yui-project/Ra-01_Handy_Neo/README.md

# Ra-01_Handy_Neo
## やりたいこと（適当）
- PC接続を不要にする
  - 0~9，Enter, BS, 文字切り替えの13ボタンによって、文字入力
  - キャラクターLCRによって、画面表示
