yui-project/Ra-01_Handy_Neo/hardware/case/components/mainpcb.step

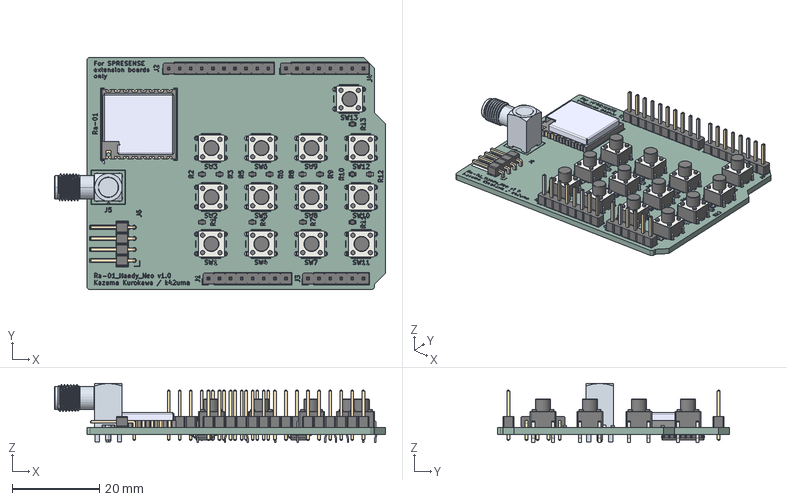
[picture p1: CAD file, 2026-05-15]
hardware/case/components/mainpcb.step
76.0 x 53.3 x 13.6 mm
PinHeader_1x08_P2.54mm_Vertical x 2
PinHeader_1x06_P2.54mm_Vertical
PinHeader_1x10_P2.54mm_Vertical
SW_PUSH_6mm_H6.5mm_Original x 13
R_0603_1608Metric x 13
Ra-01
PinHeader_1x04_P2.54mm_Horizontal
JEITA_SOIC-16_3.9x9.9mm_P1.27mm x 2
Ra-01_Handy_Neo_silkscreen
Ra-01_Handy_Neo_PCB
