yui-project/Ra-01_Handy_Neo/hardware/case/LoRa_Handy_Neo_Case_2.3mf

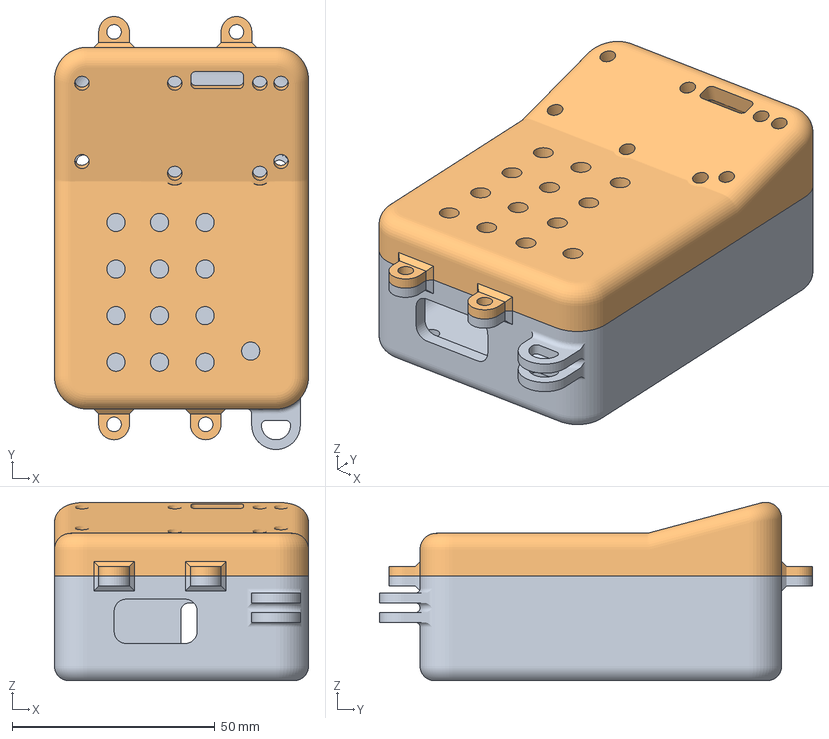
[picture p2: CAD file, 2026-07-19]
hardware/case/LoRa_Handy_Neo_Case_2.3mf
62.7 x 106.9 x 44.0 mm
ボディ1
ボディ8
