yui-project/Ra-01_Handy_Neo/hardware/case/LoRa_Handy_Button_For_Print.3mf

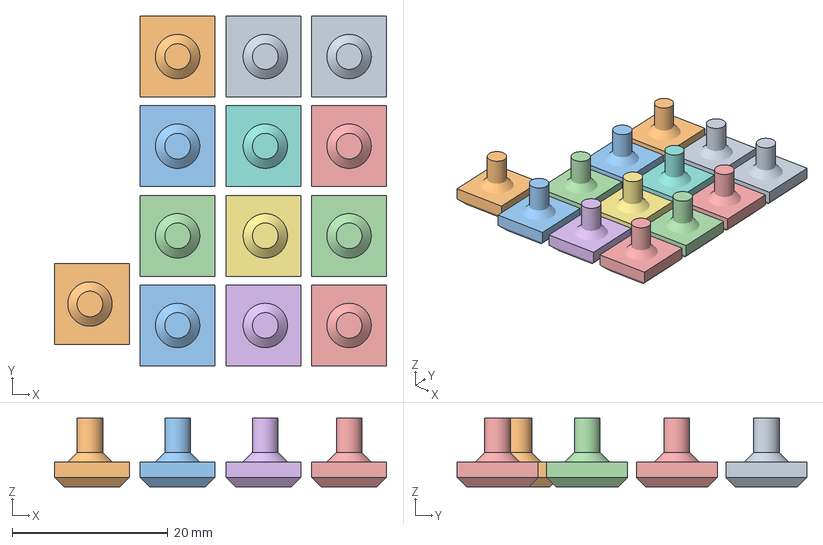
[picture p3: CAD file, 2026-07-19]
hardware/case/LoRa_Handy_Button_For_Print.3mf
42.6 x 44.9 x 8.80 mm
ボディ1
ボディ10
ボディ11
ボディ12
ボディ13
ボディ14
ボディ15
ボディ16
ボディ17
ボディ18
ボディ2
ボディ3
ボディ9
