yui-project/Ra-01_Handy_Neo/hardware/Ra-01_Handy_Neo/Ra-01_Handy_Neo.kicad_pcb

## KiCad design hardware/Ra-01_Handy_Neo/Ra-01_Handy_Neo.kicad_pcb (2026-05-15)

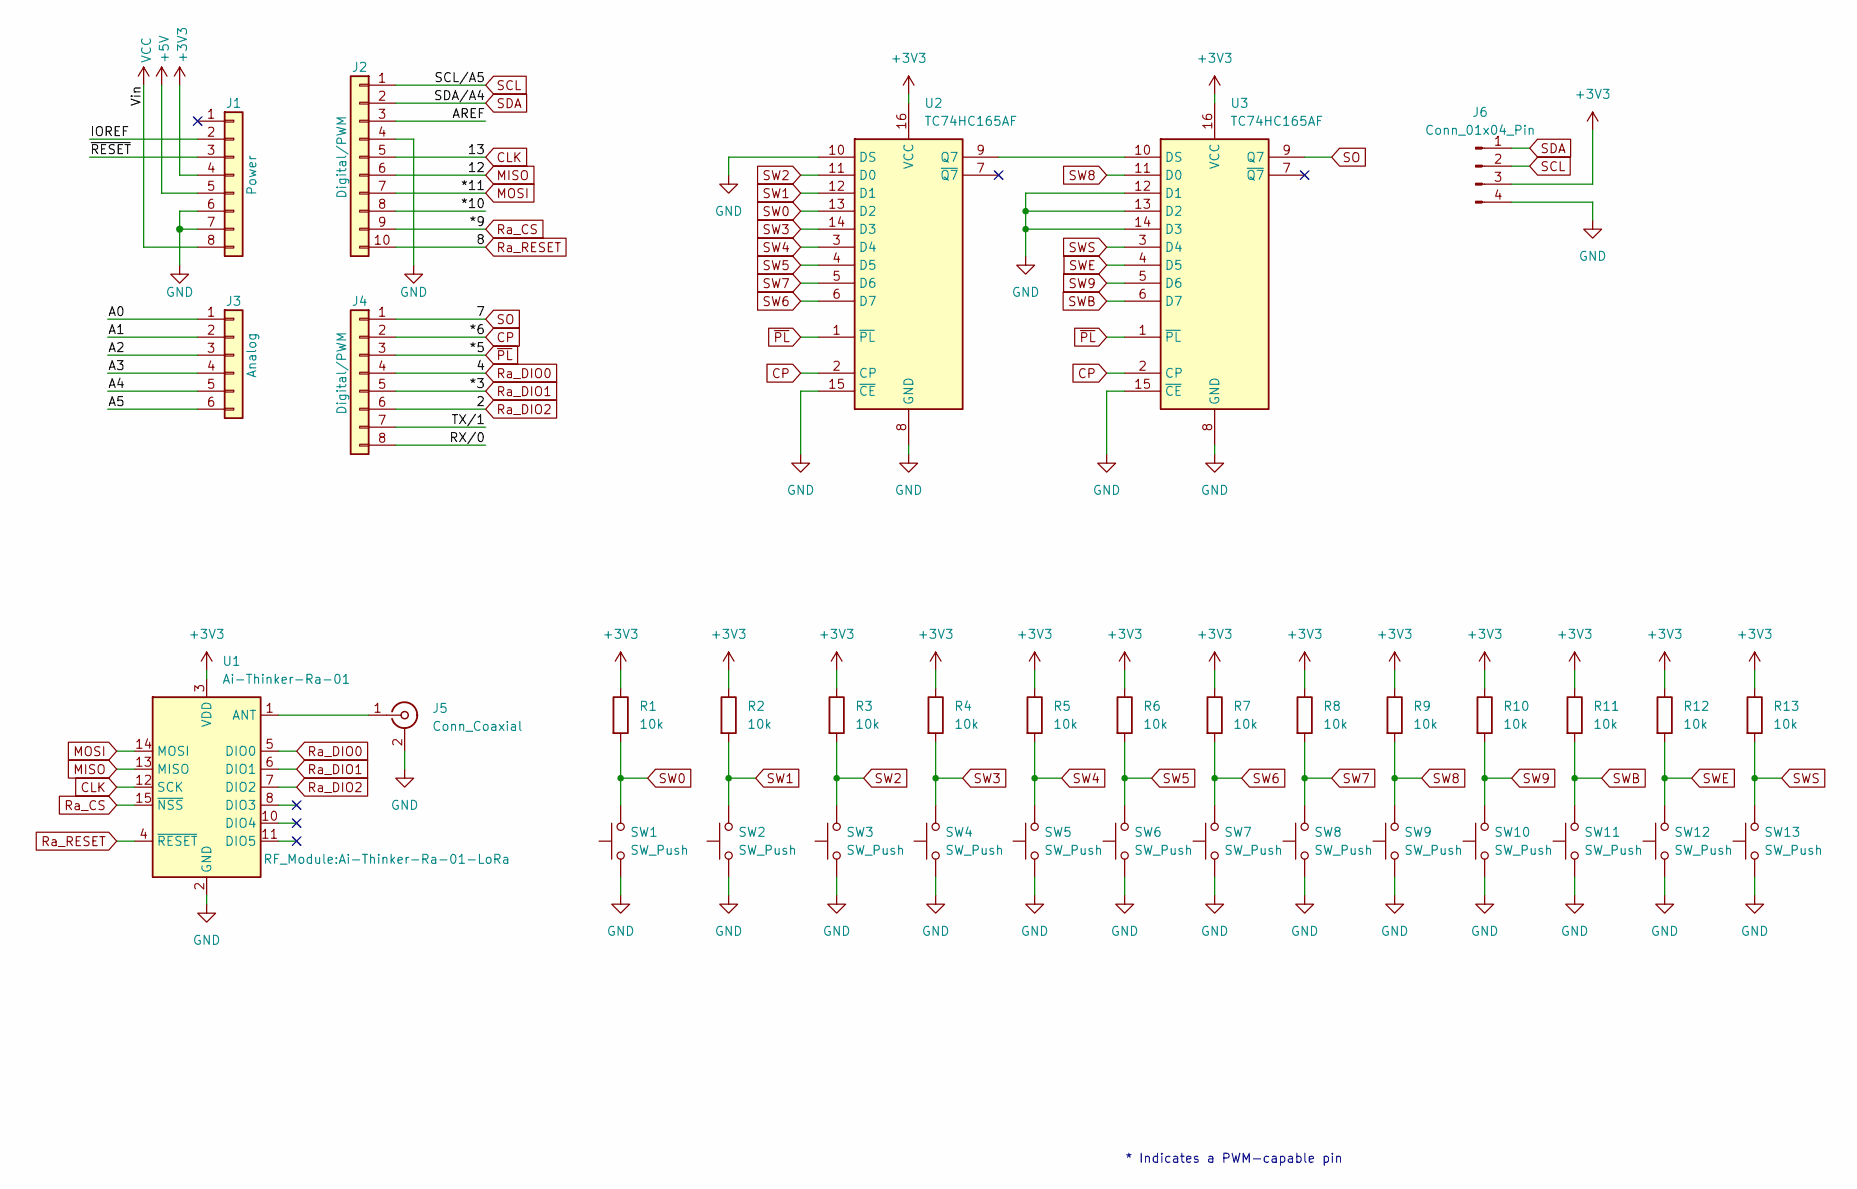
[picture p4: schematic Ra-01_Handy_Neo.kicad_sch]

Parts:
J1: Power; PinHeader_1x08_P2.54mm_Vertical
J2: Digital/PWM; PinHeader_1x10_P2.54mm_Vertical
J3: Analog; PinHeader_1x06_P2.54mm_Vertical
J4: Digital/PWM; PinHeader_1x08_P2.54mm_Vertical
J5: Conn_Coaxial; SMA_Connector_at_Honbu_3-1478978-1
J6: Conn_01x04_Pin; PinHeader_1x04_P2.54mm_Horizontal
R1, R2, R3, R4, R5, R6, R7, R8, R9, R10, R11, R12, R13: 10k; R_0603_1608Metric_Pad0.98x0.95mm_HandSolder
SW1, SW2, SW3, SW4, SW5, SW6, SW7, SW8, SW9, SW10, SW11, SW12, SW13: SW_Push; SW_PUSH_6mm_H6.5mm
U1: Ai-Thinker-Ra-01; Ai-Thinker-Ra-01-LoRa
U2, U3: TC74HC165AF; JEITA_SOIC-16_3.9x9.9mm_P1.27mm

Connections:
+3V3: J1.4, J6.3, R1.1, R2.1, R3.1, R4.1, R5.1, R6.1, R7.1, R8.1, R9.1, R10.1, R11.1, R12.1, R13.1, U1.3 (VDD), U2.16 (VCC), U3.16 (VCC)
+5V: J1.5
/*10: J2.8
/A0: J3.1
/A1: J3.2
/A2: J3.3
/A3: J3.4
/A4: J3.5
/A5: J3.6
/AREF: J2.3
/IOREF: J1.2
/RX/0: J4.8
/TX/1: J4.7
/~RESET: J1.3
CLK: J2.5, U1.12 (SCK)
CP: J4.2, U2.2 (CP), U3.2 (CP)
GND: J1.6, J1.7, J2.4, J5.2 (Ext), J6.4, SW1.1, SW2.1, SW3.1, SW4.1, SW5.1, SW6.1, SW7.1, SW8.1, SW9.1, SW10.1, SW11.1, SW12.1, SW13.1, U1.2 (GND), U1.9 (GND), U1.16 (GND), U2.8 (GND), U2.10 (DS), U2.15 (~CE), U3.8 (GND), U3.12 (D1), U3.13 (D2), U3.14 (D3), U3.15 (~CE)
MISO: J2.6, U1.13 (MISO)
MOSI: J2.7, U1.14 (MOSI)
unnamed: J5.1 (In), U1.1 (ANT)
unnamed: U2.9 (Q7), U3.10 (DS)
Ra_CS: J2.9, U1.15 (~NSS)
Ra_DIO0: J4.4, U1.5 (DIO0)
Ra_DIO1: J4.5, U1.6 (DIO1)
Ra_DIO2: J4.6, U1.7 (DIO2)
Ra_RESET: J2.10, U1.4 (~RESET)
SCL: J2.1, J6.2
SDA: J2.2, J6.1
SO: J4.1, U3.9 (Q7)
SW0: R1.2, SW1.2, U2.13 (D2)
SW1: R2.2, SW2.2, U2.12 (D1)
SW2: R3.2, SW3.2, U2.11 (D0)
SW3: R4.2, SW4.2, U2.14 (D3)
SW4: R5.2, SW5.2, U2.3 (D4)
SW5: R6.2, SW6.2, U2.4 (D5)
SW6: R7.2, SW7.2, U2.6 (D7)
SW7: R8.2, SW8.2, U2.5 (D6)
SW8: R9.2, SW9.2, U3.11 (D0)
SW9: R10.2, SW10.2, U3.5 (D6)
SWB: R11.2, SW11.2, U3.6 (D7)
SWE: R12.2, SW12.2, U3.4 (D5)
SWS: R13.2, SW13.2, U3.3 (D4)
VCC: J1.8
~PL: J4.3, U2.1 (~PL), U3.1 (~PL)

Notes on the sheet:
* Indicates a PWM-capable pin

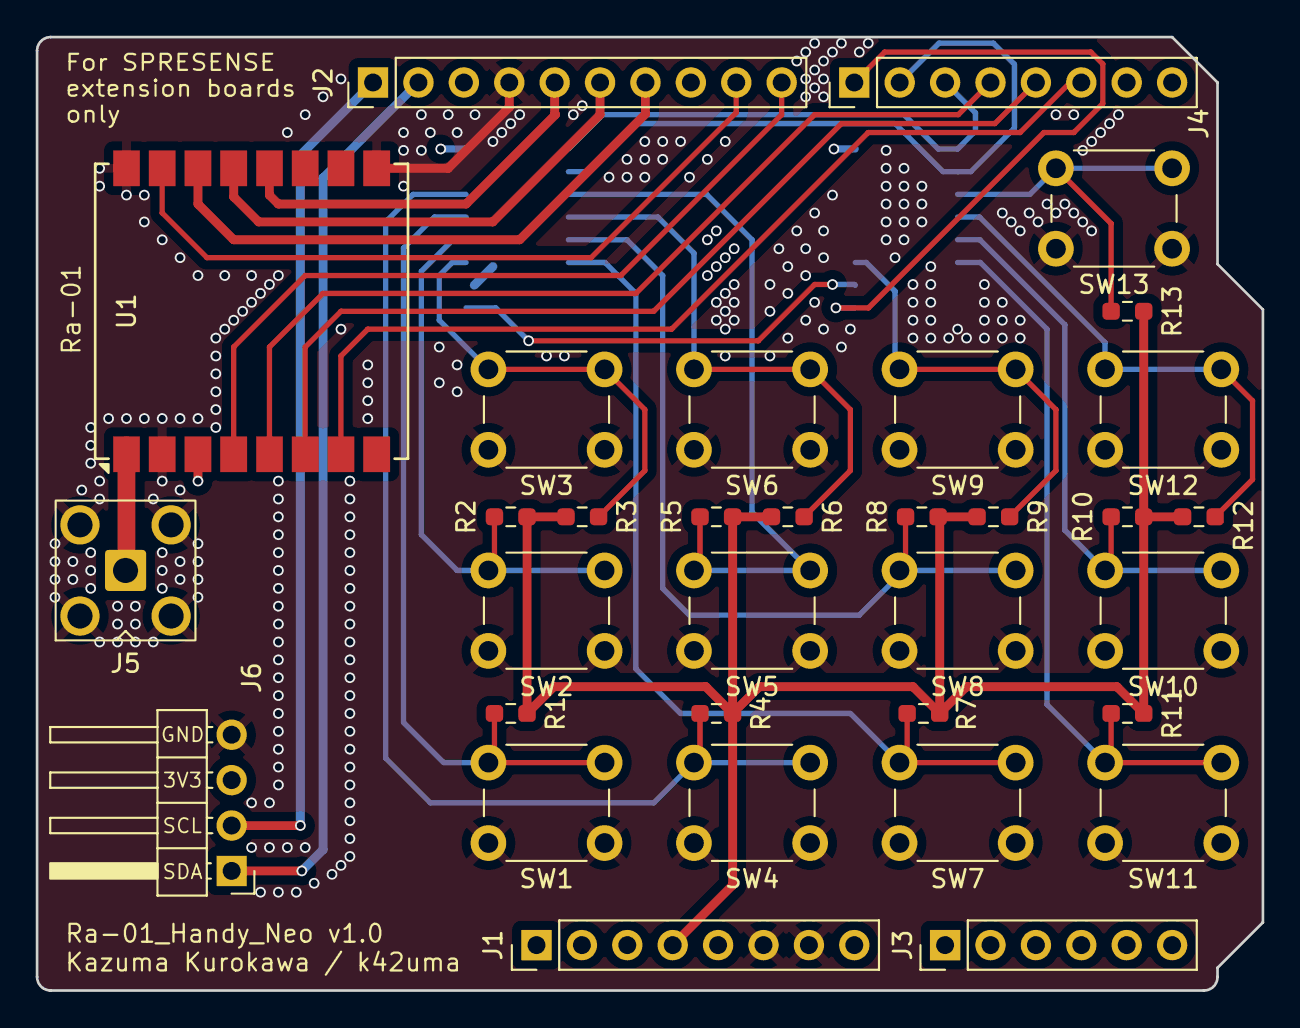
[picture p5: board Ra-01_Handy_Neo.kicad_pcb from above]

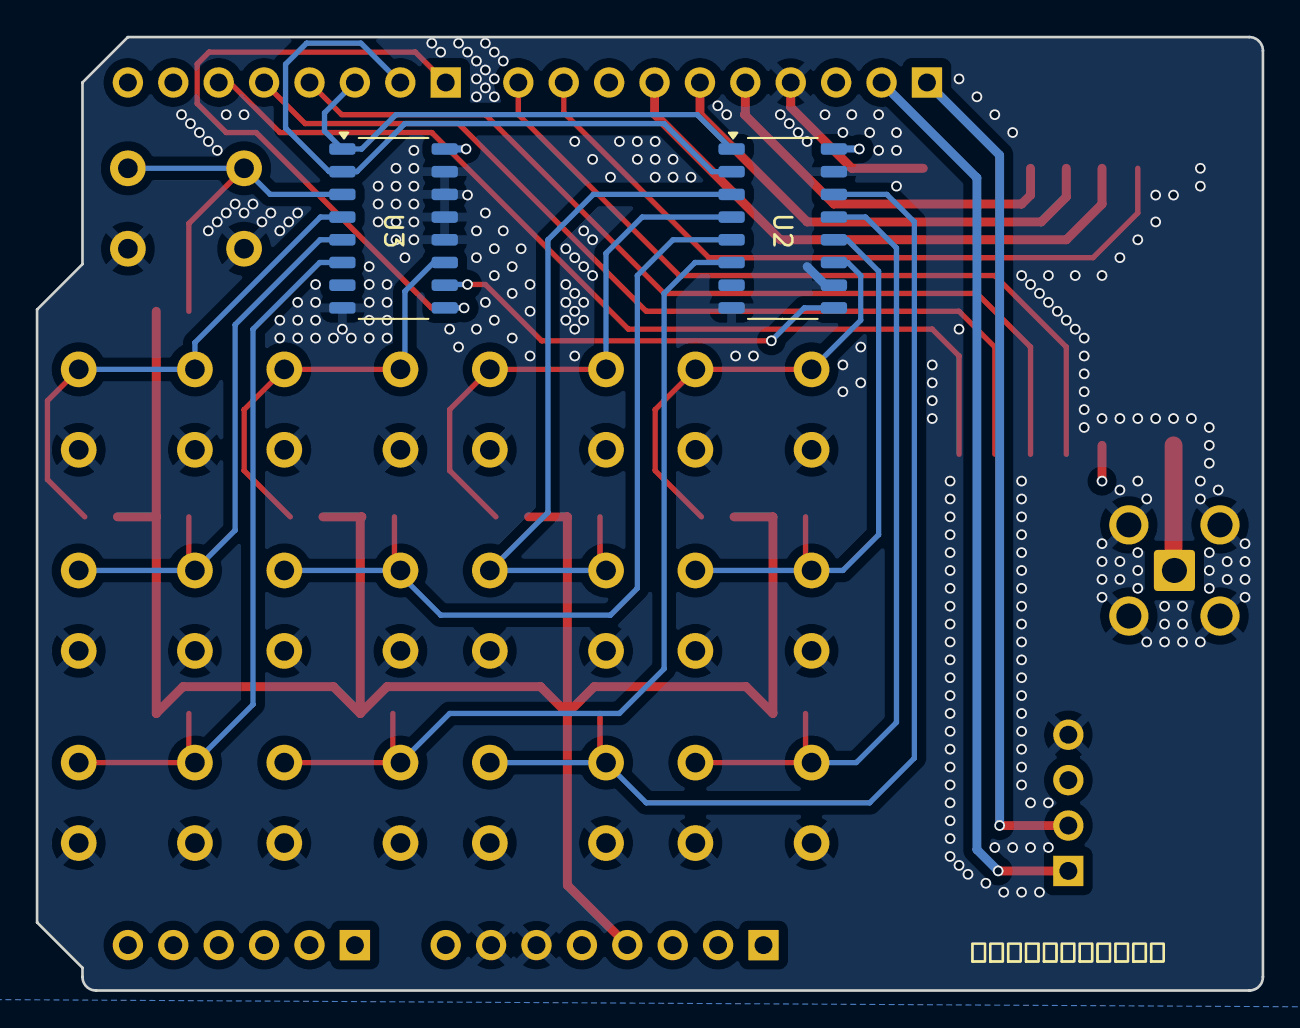
[picture p6: board Ra-01_Handy_Neo.kicad_pcb from below]

Board: 4 copper layers, 68.6 x 53.3 mm, 35 parts (2 on the bottom side), 30 nets.
