yui-project/Ra-01_Handy_Neo/src/display.h

#pragma once

#include <Wire.h>
#include <Adafruit_GFX.h>
#include <Adafruit_SSD1306.h>
#include "macros.h"

#define SCREEN_WIDTH 128 // OLED display width, in pixels
#define SCREEN_HEIGHT 64 // OLED display height, in pixels
#define CHAR_DEFAULT_HEIGHT 8

#define CHAR_MAX_LEN 21

#define MENU_SCROLL_INTERVAL_MS 150

#define OLED_RESET     -1 // Reset pin # (or -1 if sharing Arduino reset pin)

// for scrolling
constexpr const char* const MENU_MSG = "1: Send / 2: Recv ON/OFF / 3: TX Power / 4: Freq. / 5: SF / 6: BW / 7: Now Settings / 8: Log Save / 0: Close Menu / ";
constexpr const char* const CHANGE_TX_POWER_MODE_MSG = "TX Power [dbm] (2 - 20) / E: confirm  ";
constexpr const char* const CHANGE_FREQ_MODE_MSG = "Frequency [Hz] / E: confirm  ";
constexpr const char* const CHANGE_SF_MODE_MSG = "SF (6 - 12) / E: confirm  ";
constexpr const char* const CHANGE_BW_MODE_MSG = "BW (0: 7.8kHz, 1: 10.4kHz, 2: 15.6kHz, 3: 20.8kHz, 4: 31.25kHz, 5: 41.7kHz, 6: 62.5kHz, 7: 125kHz, 8: 250kHz, 9: 500kHz) / E: confirm  ";


#define YUI_LOGO_WIDTH 120
#define YUI_LOGO_HEIGHT 25

const unsigned char epd_bitmap_yui [] PROGMEM = {
	0x59, 0x21, 0x1c, 0x80, 0x00, 0x00, 0x6c, 0xf8, 0x60, 0x83, 0x1f, 0xf4, 0x03, 0xaa, 0xb3, 0xfd, 
	0xf9, 0x1f, 0xb8, 0xf3, 0xcc, 0x7f, 0xfb, 0xf7, 0xef, 0xff, 0xff, 0xfb, 0xff, 0xff, 0xfb, 0xbf, 
	0xff, 0xf2, 0x37, 0xec, 0x7f, 0xeb, 0xc7, 0xef, 0xff, 0xfc, 0x67, 0xff, 0xff, 0xf1, 0xf1, 0x8f, 
	0x36, 0x67, 0xe9, 0x7f, 0xf9, 0xa0, 0x8f, 0xbf, 0xfe, 0x63, 0xcf, 0xbf, 0x7f, 0xf3, 0x9f, 0x8c, 
	0xf1, 0x9b, 0x7f, 0xff, 0xf3, 0xff, 0xbf, 0xfc, 0x67, 0xff, 0xff, 0xef, 0xfe, 0xe6, 0x39, 0x9b, 
	0x1f, 0xfe, 0xff, 0xb1, 0x8f, 0xbf, 0xff, 0xf8, 0x82, 0x7f, 0x47, 0xdc, 0x6e, 0x21, 0x0a, 0x00, 
	0x36, 0xb6, 0xb1, 0x8f, 0xbb, 0xec, 0x01, 0x86, 0x07, 0x00, 0x00, 0x00, 0x00, 0x00, 0x00, 0x00, 
	0x00, 0x00, 0x00, 0x00, 0x00, 0x00, 0x00, 0x00, 0x00, 0x00, 0x00, 0x00, 0x00, 0x00, 0x00, 0x00, 
	0x00, 0x00, 0x00, 0x00, 0x00, 0x00, 0x00, 0x00, 0x00, 0x00, 0x00, 0x00, 0x00, 0x00, 0x00, 0x00, 
	0x00, 0x00, 0x00, 0x00, 0x00, 0x00, 0x7c, 0x0c, 0x70, 0x00, 0x00, 0x01, 0xc0, 0x00, 0x02, 0x06, 
	0x00, 0x00, 0x3c, 0x00, 0xc0, 0x7e, 0x18, 0x70, 0x00, 0x00, 0x03, 0xc0, 0x00, 0x07, 0x1f, 0x00, 
	0x00, 0x3c, 0x00, 0xe0, 0x78, 0x30, 0x38, 0x00, 0x00, 0x1f, 0x80, 0x7e, 0x03, 0x9a, 0x00, 0x00, 
	0x3e, 0x00, 0xe0, 0x70, 0x73, 0xf8, 0x00, 0x00, 0xff, 0x06, 0xfe, 0x03, 0x88, 0x00, 0x00, 0xff, 
	0x80, 0xe0, 0x70, 0x7b, 0xf8, 0x06, 0x03, 0xff, 0x06, 0xfe, 0x04, 0x08, 0x00, 0x01, 0xff, 0x80, 
	0xc0, 0x60, 0xfb, 0xf8, 0x07, 0x07, 0xff, 0x06, 0x1e, 0x07, 0x18, 0x00, 0x01, 0xff, 0x80, 0xf8, 
	0x60, 0x79, 0xf0, 0x06, 0x07, 0xde, 0x06, 0x3e, 0x07, 0x30, 0x0f, 0x00, 0x9f, 0x00, 0xfe, 0x60, 
	0x78, 0xf8, 0x06, 0x03, 0x9e, 0x07, 0x3c, 0x02, 0x70, 0x1f, 0x00, 0x1e, 0x00, 0xce, 0x60, 0xfd, 
	0xf0, 0x06, 0x00, 0x3c, 0x07, 0x7c, 0x00, 0xe0, 0x07, 0x00, 0x3c, 0x00, 0xce, 0x00, 0xfc, 0xfe, 
	0x06, 0x00, 0x78, 0x07, 0xfe, 0x07, 0xe0, 0x07, 0x80, 0x78, 0x00, 0xc0, 0x00, 0x3b, 0xce, 0x06, 
	0x00, 0x70, 0x07, 0xfe, 0x07, 0xc0, 0x1f, 0x80, 0xe0, 0x00, 0xc0, 0x00, 0x7b, 0xbe, 0x06, 0x01, 
	0xc0, 0x03, 0x00, 0x0f, 0x80, 0x18, 0x01, 0xc0, 0x00, 0xe0, 0x00, 0xfb, 0xfe, 0x3e, 0x01, 0x80, 
	0x00, 0x00, 0x00, 0x00, 0x00, 0x03, 0x80, 0x00, 0xc0, 0x00, 0xf3, 0xfe, 0x3e, 0x00, 0x00, 0x00, 
	0x00, 0x00, 0x00, 0x00, 0x03, 0x00, 0x00, 0x40, 0x00, 0x20, 0xfc, 0x00, 0x00, 0x00, 0x00, 0x00, 
	0x00, 0x00, 0x00, 0x00, 0x00, 0x00, 0x00
};

// modes
#define DEFAULT_MODE 0
#define MENU_MODE 1
#define CHANGE_RECV_MODE 2
#define SEND_MODE 3
#define SEND_DONE_MODE 4
#define CHANGE_TX_POWER_MODE 5
#define CHANGE_FREQ_MODE 6
#define CHANGE_SF_MODE 7
#define CHANGE_BW_MODE 8
#define CHANGE_TX_POWER_DONE_MODE 9
#define CHANGE_FREQ_DONE_MODE 10
#define CHANGE_SF_DONE_MODE 11
#define CHANGE_BW_DONE_MODE 12
#define SHOW_NOW_SETTINGS_MODE 13
#define SHOW_LOG_SAVE_DONE_MODE 14
class Display{
    private:
        Adafruit_SSD1306 display{SCREEN_WIDTH, SCREEN_HEIGHT, &Wire, OLED_RESET};

        uint8_t whatToShow = DEFAULT_MODE;
        uint32_t menuLastMillis = 0;
        uint16_t menuCount = 0;
        uint32_t nonMenuLastMillis = 0;
        uint16_t nonMenuCount = 0;

    public:
        uint8_t begin();
        uint8_t flush();
        uint8_t clear();
        uint8_t showRecv(const char *recv1, const char *recv1Time, const char *recv2, const char *recv2Time);
        uint8_t showSeparateLine();
        uint8_t showGuideToMenu(uint8_t recvMode);
        uint8_t showMenu();
        uint8_t showChangeRecvMode(uint8_t recvMode);
        uint8_t showSend(const char* input, const char* pendingChar);
        uint8_t showSendDone();
        uint8_t showChangeParams(const char* input);
        uint8_t showChangeParamsDone(uint32_t param);
        uint8_t showNowSettings(const char* nowTime, bool isSDEnabled, uint8_t recvMode, uint32_t txPower, uint32_t freq, uint32_t sf, uint32_t bw);
        uint8_t showLogSaveDone(uint8_t num);
        uint8_t showYuiLogo();
        uint8_t getWhatToShow();
        uint8_t changeWhatToShow(uint8_t wts);

};
