yui-project/Ra-01_Handy_Neo/src/DefinesForSprExt.h

// Situation Defines
// #define BUTTON_TEST // ボタン類のテスト
// #define ENTER_TEST // 文字入力テスト
// #define DISPLAY_TEST // ディスプレイ表示テスト // 非推奨
// #define YUI_LOGO_TEST // 起動時に結ロゴを表示するテスト
#define DEFAULT // 通常使用時

#define IS_SERIAL // 【すべてのコンポーネントで】シリアル通信でのデバッグ出力を有効にする

// params
#define OPENING_YUI_LOGO // 起動時に結ロゴを表示する

#define LOG_CAPACITY 128
#define LOG_DATA_MAX_LEN 64

#define SD_CARD_SEARCHING_COUNT 6

// Digital Pins
#define RA_CS 9
#define RA_RESET 10
#define RA_DIO0 4
#define RA_DIO1 3
#define RA_DIO2 2

#define BSR_SO 7
#define BSR_CP 6
#define BSR_PL 5
