yui-project/Ra-01_Handy_Neo/src/examples/sd/sd.ino

/*
 *  read_write.ino - SD card read/write sample application
 *  Copyright 2019 Sony Semiconductor Solutions Corporation
 *
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
 *  You should have received a copy of the GNU Lesser General Public
 *  License along with this library; if not, write to the Free Software
 *  Foundation, Inc., 51 Franklin St, Fifth Floor, Boston, MA  02110-1301  USA
 */

/**
 * @file read_write.ino
 * @author Sony Semiconductor Solutions Corporation
 * @brief SD card read/write sample application.
 */

#include <Arduino.h>
#include <SDHCI.h>
#include <File.h>

SDClass SD;  /**< SDClass object */ 

File myFile; /**< File object */ 

/**
 * @brief Write to the file and read from the file.
 * 
 * @details The file is located on the SD card.
 */
void setup() {

  /* Open serial communications and wait for port to open */
  Serial.begin(115200);
  while (!Serial) {
    ; /* wait for serial port to connect. Needed for native USB port only */
  }

  /* Initialize SD */
  Serial.print("Insert SD card.");
  while (!SD.begin()) {
    Serial.println("WAITING FOR SD CARD"); /* wait until SD card is mounted. */
  }

  /* Create a new directory */
  SD.mkdir("dir/");

  /* Open the file. Note that only one file can be open at a time,
     so you have to close this one before opening another. */
  myFile = SD.open("dir/test.txt", FILE_WRITE);

  /* If the file opened okay, write to it */
  if (myFile) {
    Serial.print("Writing to test.txt...");
    myFile.println("testing 1, 2, 3.");
    /* Close the file */
    myFile.close();
    Serial.println("done.");
  } else {
    /* If the file didn't open, print an error */
    Serial.println("error opening test.txt");
  }

  /* Re-open the file for reading */
  myFile = SD.open("dir/test.txt");

  if (myFile) {
    Serial.println("test.txt:");

    /* Read from the file until there's nothing else in it */
    while (myFile.available()) {
      Serial.write(myFile.read());
    }
    /* Close the file */
    myFile.close();
  } else {
    /* If the file didn't open, print an error */
    Serial.println("error opening test.txt");
  }
}

/**
 * @brief Run repeatedly.
 * 
 * @details Does not do anything.
 */
void loop() {

}
