yui-project/Ra-01_Handy_Neo/(commit log)

2026-05-08 add templates
    [Handy_LoRa-B_Cu.gbr, Handy_LoRa-B_Mask.gbr, Handy_LoRa-B_Paste.gbr, Handy_LoRa-B_Silkscreen.gbr, Handy_LoRa-Edge_Cuts.gbr, Handy_LoRa-F_Cu.gbr, Handy_LoRa-F_Mask.gbr, Handy_LoRa-F_Paste.gbr]
2026-05-09 add buttons and ra01 to sch
    [Ra-01_Handy_Neo.kicad_pcb, Ra-01_Handy_Neo.kicad_sch]
2026-05-11 80% done
    [Ra-01_Handy_Neo.kicad_pcb, Ra-01_Handy_Neo.kicad_sch]
2026-05-12 pcb almost complete
    [Ra-01_Handy_Neo.kicad_pcb, Ra-01_Handy_Neo.kicad_sch]
2026-05-12 add gitignore to ignore kicad backups
2026-05-12 modify back silkscreen
    [Ra-01_Handy_Neo.kicad_pcb]
2026-05-13 change designs
    [Ra-01_Handy_Neo.kicad_pcb]
2026-05-14 change Resister posi
    [Ra-01_Handy_Neo.kicad_pcb]
2026-05-14 del old dir
    [Handy_LoRa-B_Cu.gbr, Handy_LoRa-B_Mask.gbr, Handy_LoRa-B_Paste.gbr, Handy_LoRa-B_Silkscreen.gbr, Handy_LoRa-Edge_Cuts.gbr, Handy_LoRa-F_Cu.gbr, Handy_LoRa-F_Mask.gbr, Handy_LoRa-F_Paste.gbr]
2026-05-14 hardware: push files for jlcpcb
    [Ra-01_Handy_Neo.kicad_pcb, bom.csv, designators.csv, positions.csv]
2026-05-15 change footprints and 3dsymbols to export step file
    [Ra-01_Handy_Neo.kicad_pcb, Ra-01_Handy_Neo.kicad_sch, Ra-01_Handy_Neo.step]
2026-05-21 add correct showRecv before ope conf
    [src.ino]
2026-07-16 make case dir and add pcb step file
    [pcb.step]
2026-07-18 add step files
    [mainpcb.step]
2026-07-19 add case 3mf files
    [LoRa_Handy_Button_For_Print.3mf, LoRa_Handy_Neo_Case_2.3mf]
